movich4/LIPO-INFERNO/adhesivos/pdf/pegatina dreta.pdf

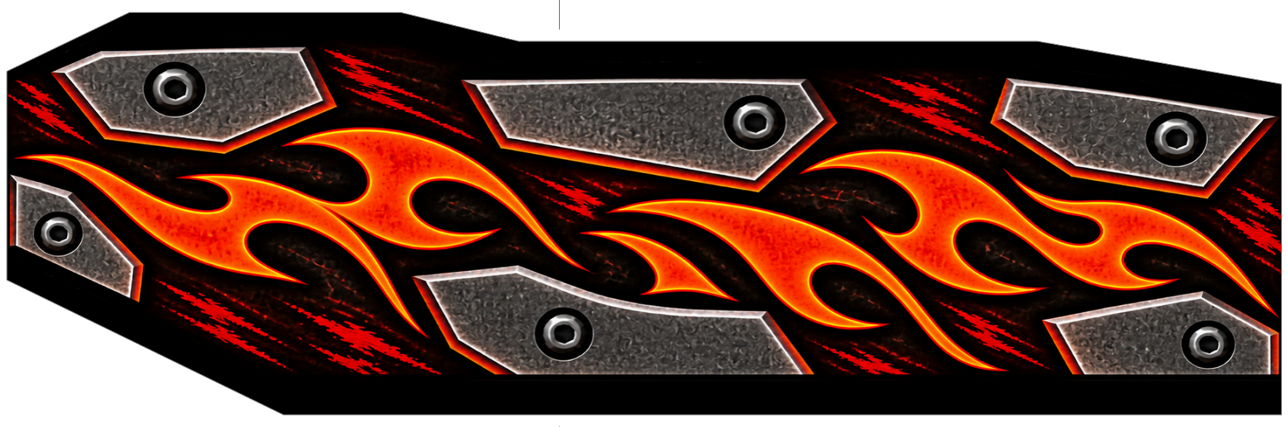
[picture p11: figure]

Plec 135 graus - no tallar

## LATERAL DRET - PECA UNICA

Cara 1: 47 mm | Cara 2: 61,4305 mm | Total: 108,4305 mm
Altura de la unio: 31,8 mm | Extrem dret: 28,1556 mm
Imprimir al 100% / mida real. No ajustar a la pagina ni fer mirall.
Retallar el contorn. Doblegar per les marques exteriors, sense tallar la unio.

Control: 50 mm
