movich4/LIPO-INFERNO/adhesivos/pdf/pegatina esquerra.pdf

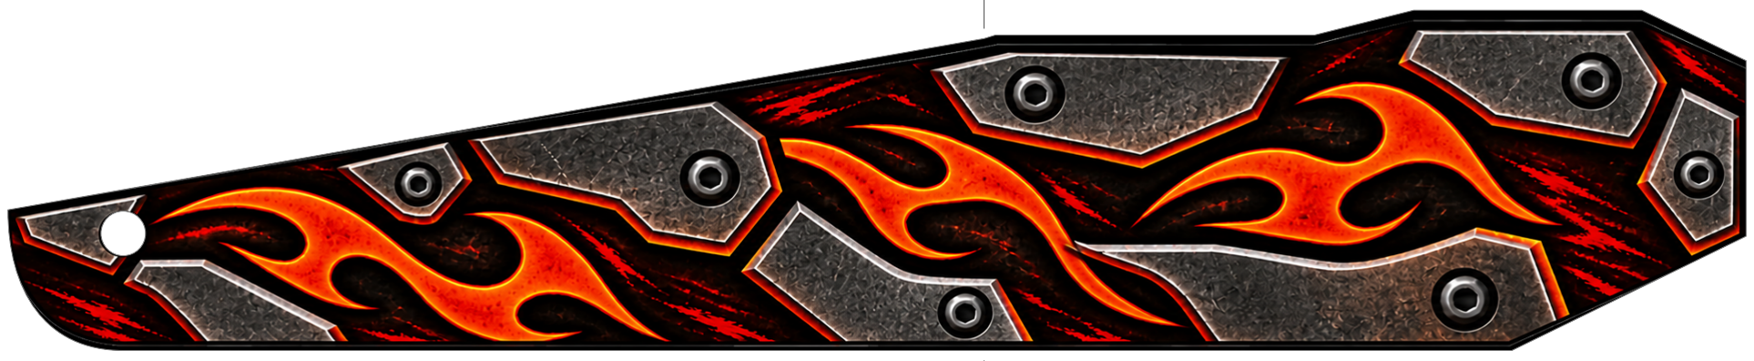
[picture p12: figure]

Plec 135 graus - no tallar

## LATERAL ESQUERRE - PECA UNICA

Cara 1: 98,6363 mm | Cara 2: 77 mm | Total: 175,6363 mm
Altura de la unio: 31,4915 mm | Forat: diametre 4,5 mm
Imprimir al 100% / mida real. No ajustar a la pagina.
Retallar nomes el contorn i el forat. Doblegar per les marques exteriors.

Control: 50 mm
