movich4/LIPO-INFERNO/adhesivos/pdf/Pegatina superior.pdf

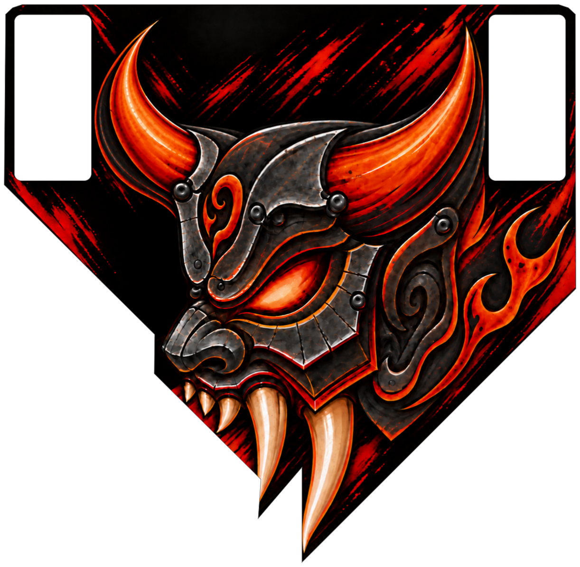
[picture p13: figure]

Imprimir al 100% / mida real. No ajustar a la pagina.
Amplada exterior: 165 mm. Retallar el contorn i els forats blancs.

Control: 50 mm
