movich4/LIPO-INFERNO/adhesivos/pdf/pegatina_inferior.pdf

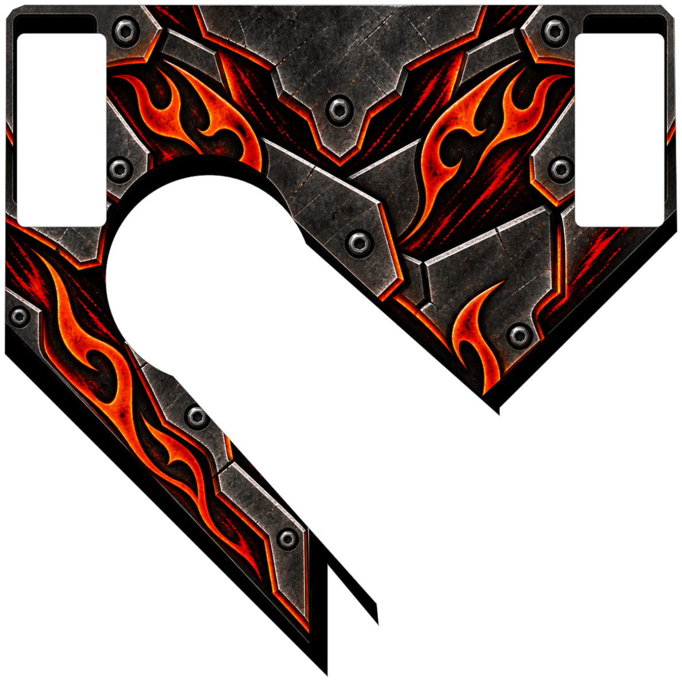
[picture p14: figure]

Sota del xassis - amplada 165 mm - vora superior +4 mm Forats i zona inferior conservats. Contorn ja en mirall. Imprimir al 100%. No ajustar a la pagina ni tornar a fer mirall.

Control: 50 mm
