movich4/LIPO-INFERNO/THIRD_PARTY.md

# Material y derechos de terceros

Las licencias del proyecto cubren las aportaciones propias de movich4. No conceden derechos que pertenezcan a otras personas o entidades.

## Imágenes de anuncios

Los siguientes archivos se presentan en el README como imágenes del anuncio de la motosierra:

- `media/imagenes/desarrollo/Aliexpress.png`
- `media/imagenes/desarrollo/pes_original.png`

Se excluyen de la dedicación CC0 del proyecto. No consta aquí una licencia de reutilización concedida por sus titulares. Su presencia en este repositorio no concede permiso para reutilizar esos anuncios.

## Otros elementos externos

Los derechos de terceros sobre marcas, logotipos, interfaces o contenido externo que pueda aparecer en capturas, fotografías, vídeos o gráficos permanecen con sus respectivos titulares. La licencia del material propio no concede por sí sola derechos sobre esos elementos ni implica su respaldo al proyecto.

Las bibliotecas y herramientas externas utilizadas para compilar o desarrollar el robot mantienen sus respectivas licencias. La licencia MIT del código propio no sustituye las condiciones de esas dependencias.
