movich4/LIPO-INFERNO/media/imagenes/desarrollo/60ca14e7-3f66-41a6-87e7-86d295f8432b.jpg

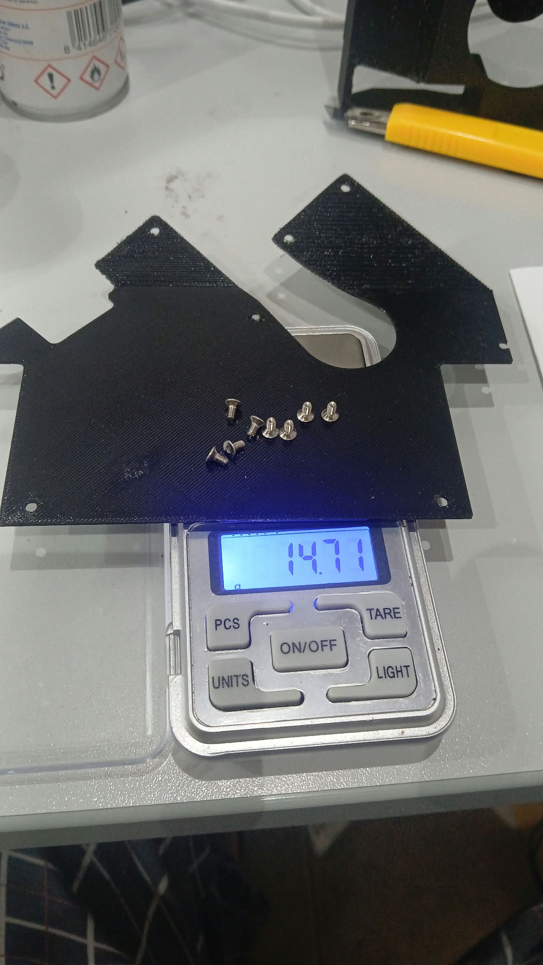
media/imagenes/desarrollo/60ca14e7-3f66-41a6-87e7-86d295f8432b.jpg
