movich4/LIPO-INFERNO/media/imagenes/desarrollo/92ebfd58-8bb9-44ca-aabc-aaffa1bcd1ce.jpg

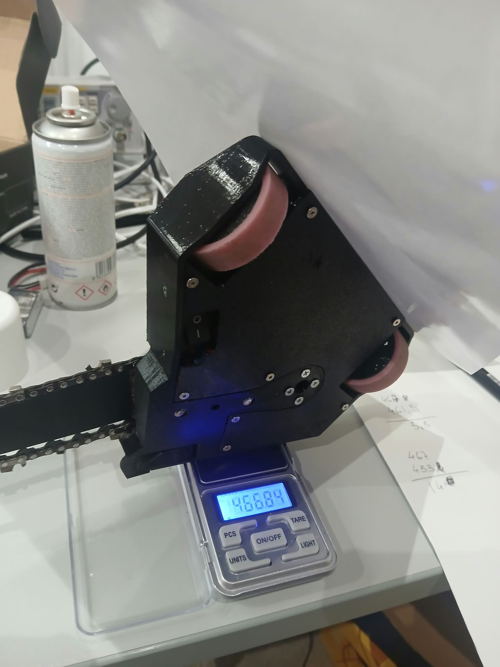
media/imagenes/desarrollo/92ebfd58-8bb9-44ca-aabc-aaffa1bcd1ce.jpg
