movich4/LIPO-INFERNO/media/imagenes/desarrollo/536af13c-256c-49a1-b3da-b9dbb056d0e5.jpg

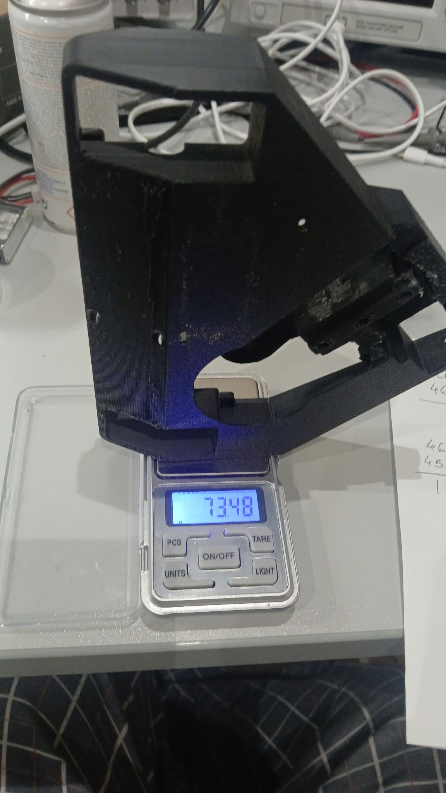
media/imagenes/desarrollo/536af13c-256c-49a1-b3da-b9dbb056d0e5.jpg
