movich4/LIPO-INFERNO/media/imagenes/desarrollo/af1d88e6-dc71-4df8-9051-c0cca1b3e629.jpg

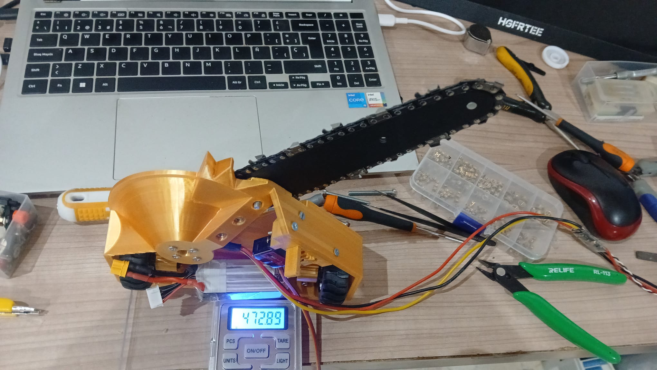
media/imagenes/desarrollo/af1d88e6-dc71-4df8-9051-c0cca1b3e629.jpg
