movich4/LIPO-INFERNO/media/imagenes/desarrollo/brushless_1.png

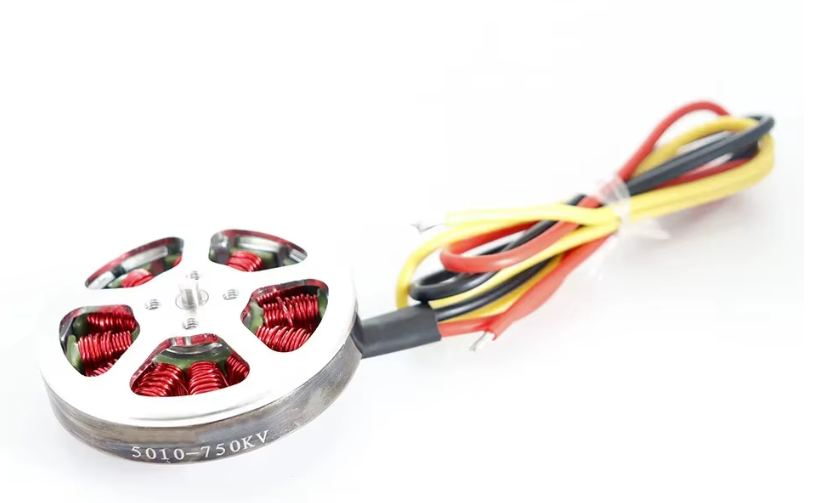
media/imagenes/desarrollo/brushless_1.png
