movich4/LIPO-INFERNO/media/imagenes/desarrollo/camiseta.png

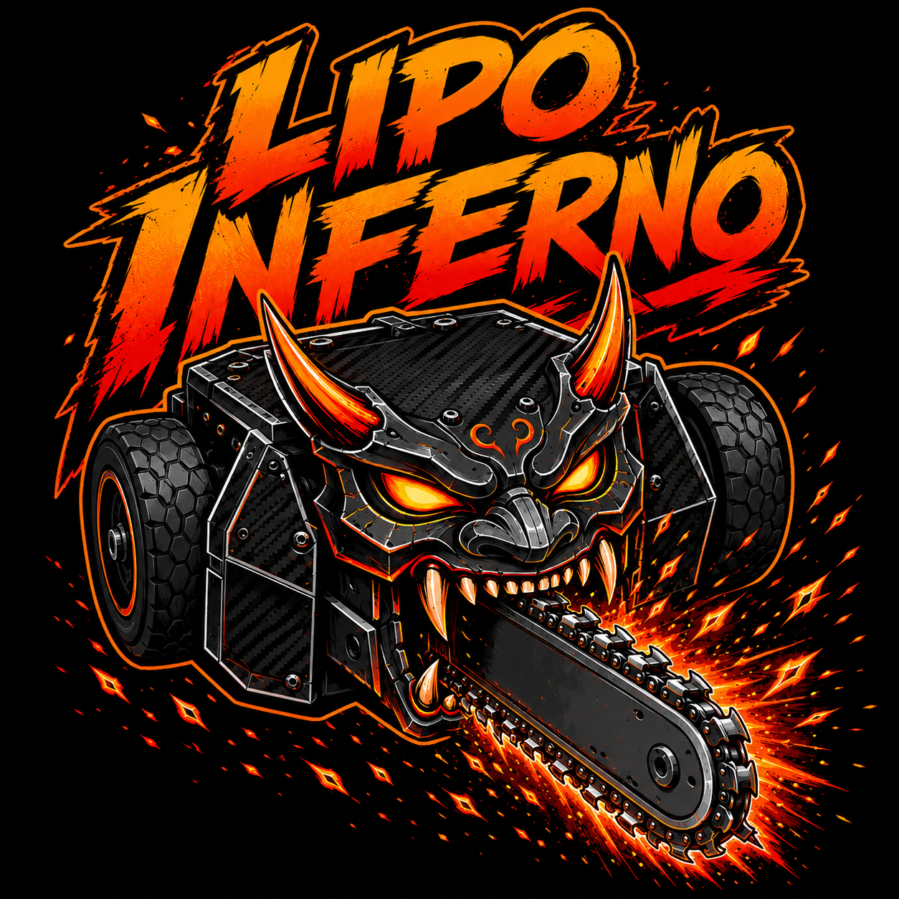
media/imagenes/desarrollo/camiseta.png
