movich4/LIPO-INFERNO/media/imagenes/desarrollo/Captura de pantalla 2026-10-26 194523.png

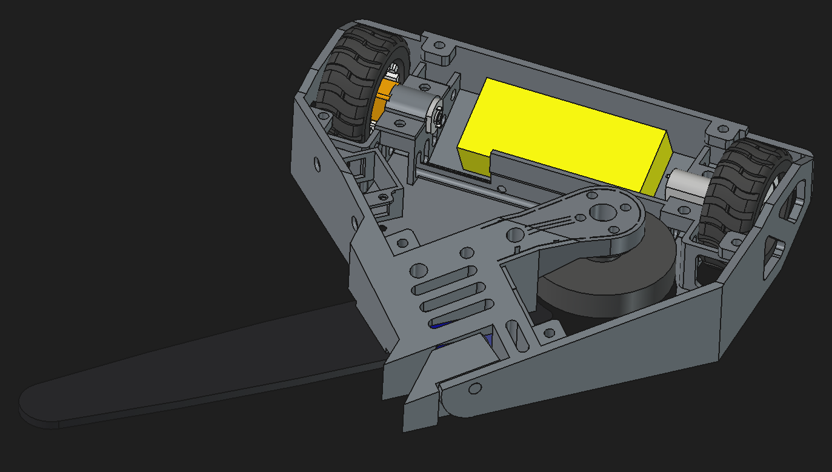
media/imagenes/desarrollo/Captura de pantalla 2026-10-26 194523.png
