movich4/LIPO-INFERNO/media/imagenes/desarrollo/concepte-lipo-inferno.png

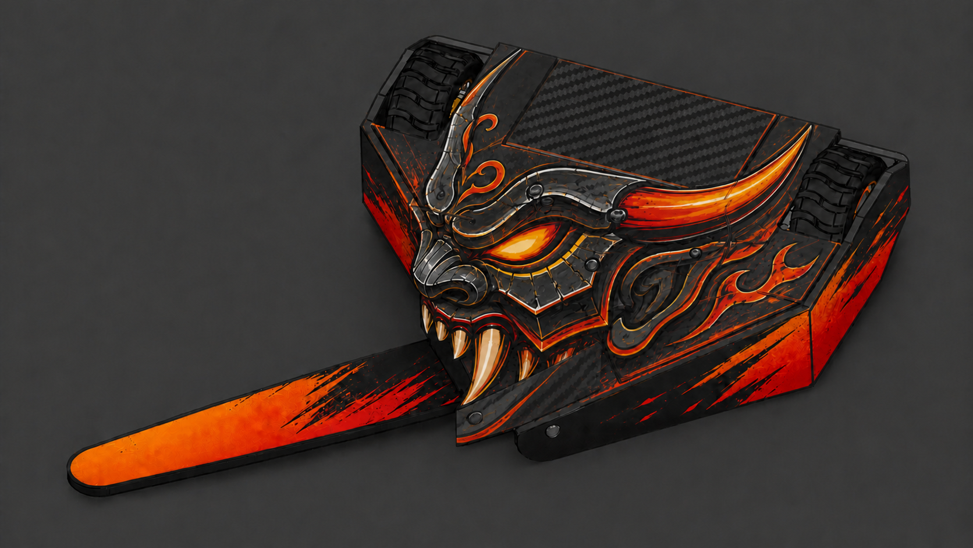
media/imagenes/desarrollo/concepte-lipo-inferno.png
