movich4/LIPO-INFERNO/media/imagenes/desarrollo/d8155282-41f2-4d60-a6fd-6150cf6f09d9.jpg

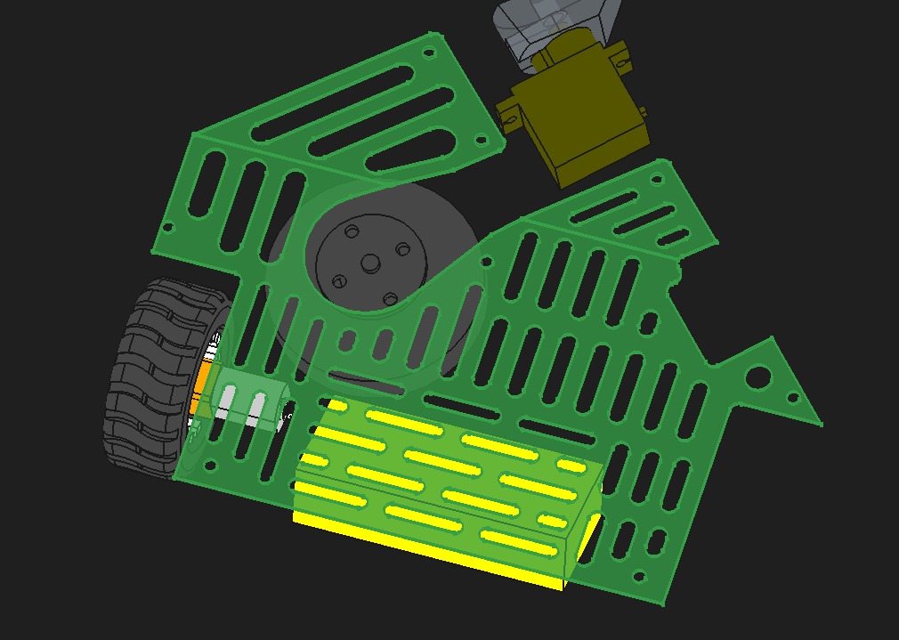
media/imagenes/desarrollo/d8155282-41f2-4d60-a6fd-6150cf6f09d9.jpg
