movich4/LIPO-INFERNO/media/imagenes/desarrollo/ef5335f4-c31e-446f-8f8a-f5f91df906e8.jpg

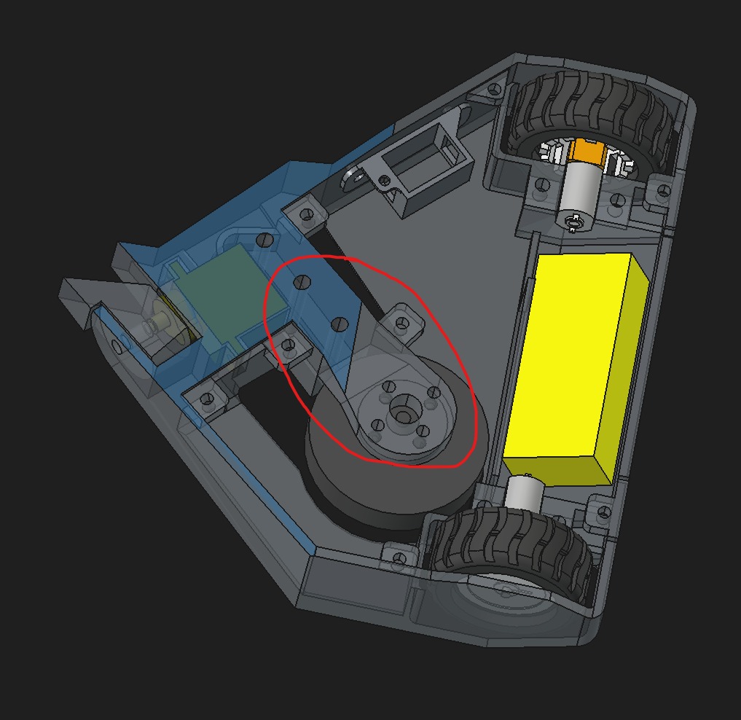
media/imagenes/desarrollo/ef5335f4-c31e-446f-8f8a-f5f91df906e8.jpg
