movich4/LIPO-INFERNO/media/imagenes/desarrollo/muntatge-interior.jpg

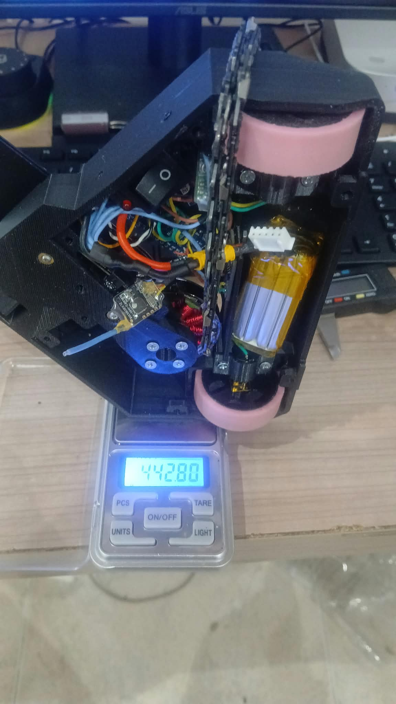
media/imagenes/desarrollo/muntatge-interior.jpg
