movich4/LIPO-INFERNO/media/imagenes/desarrollo/sumaker-team.png

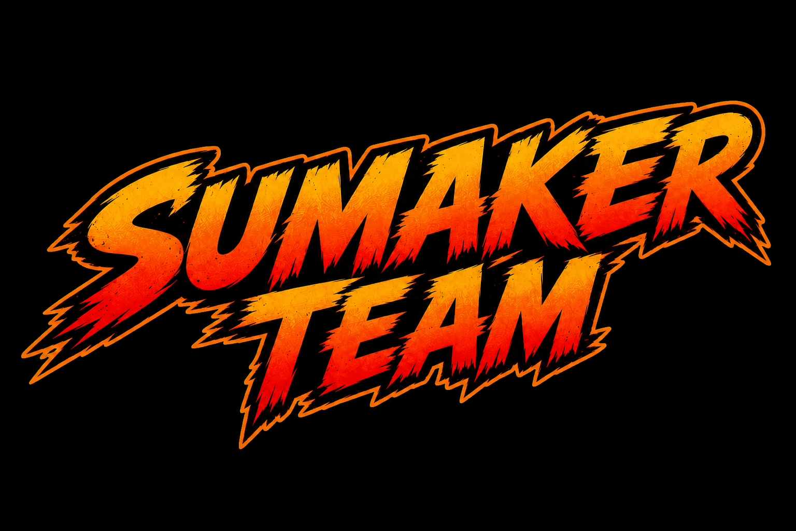
media/imagenes/desarrollo/sumaker-team.png
