movich4/LIPO-INFERNO/media/imagenes/robot/alternativas/20261031_154808-sin-fondo.png

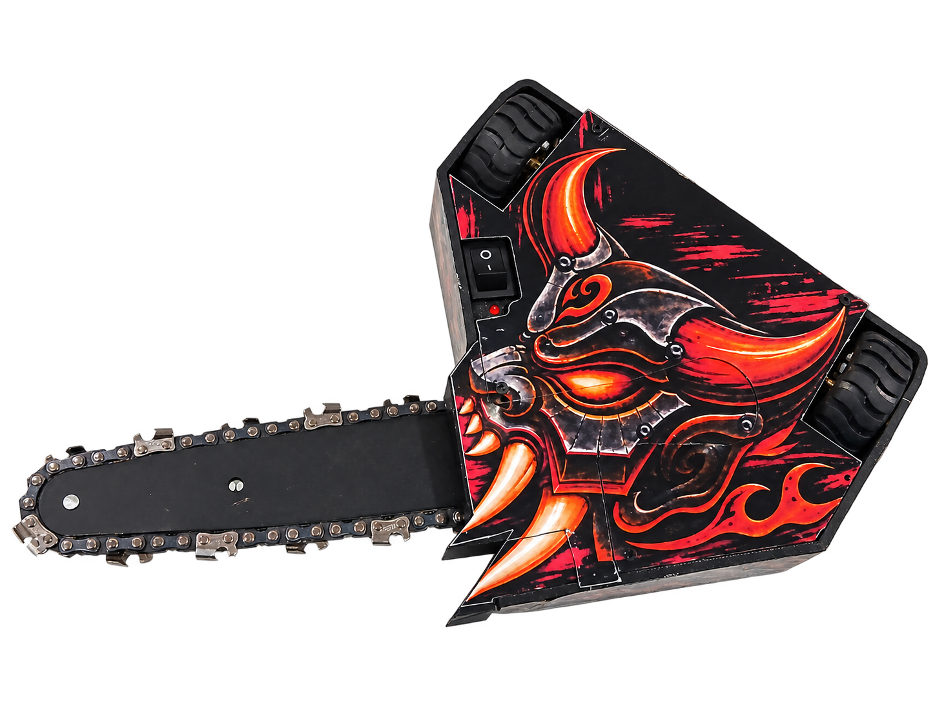
media/imagenes/robot/alternativas/20261031_154808-sin-fondo.png
