movich4/LIPO-INFERNO/media/imagenes/robot/originales/20261031_154808.jpg

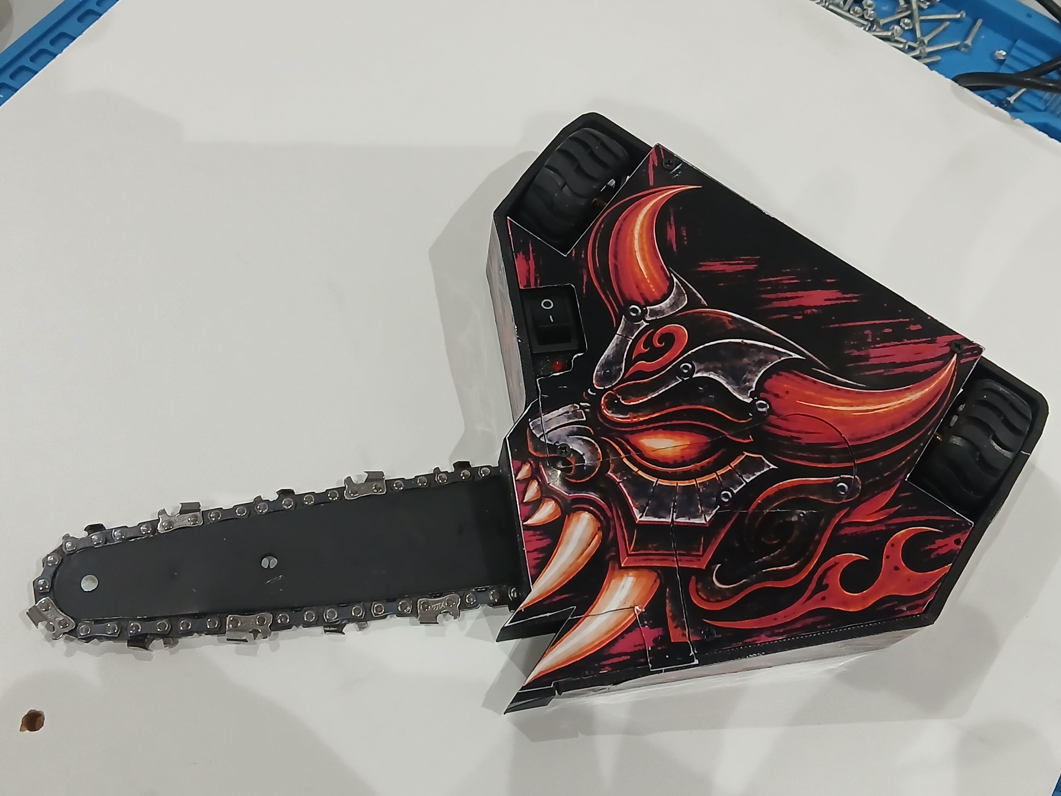
media/imagenes/robot/originales/20261031_154808.jpg
