movich4/LIPO-INFERNO/media/imagenes/robot/originales/20261031_154931.jpg

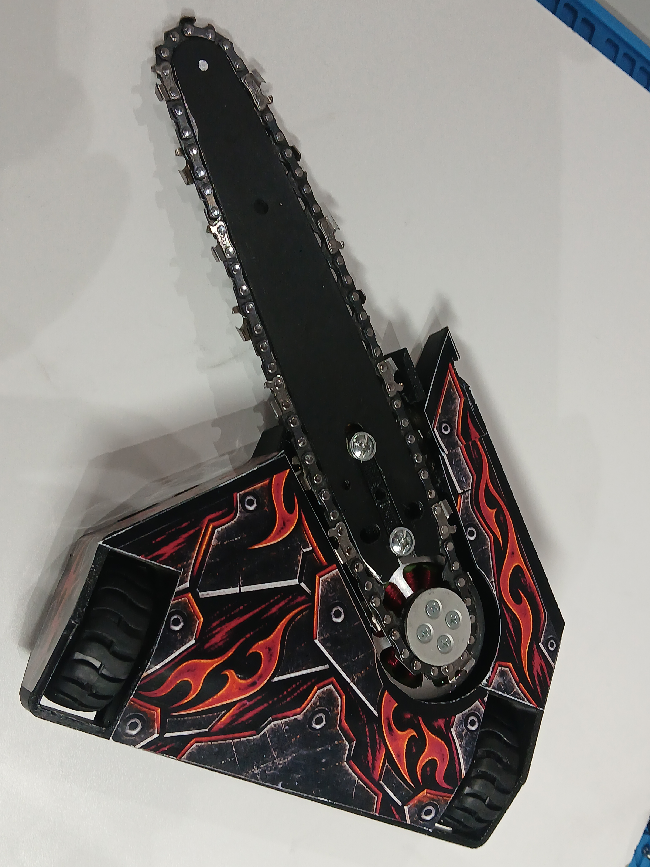
media/imagenes/robot/originales/20261031_154931.jpg
