movich4/LIPO-INFERNO/media/imagenes/robot/originales/20261031_155024.jpg

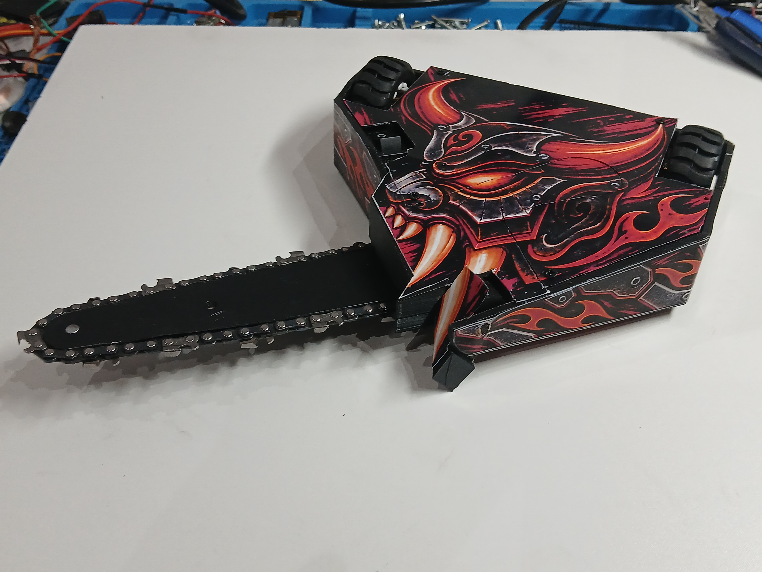
media/imagenes/robot/originales/20261031_155024.jpg
