movich4/LIPO-INFERNO/cad/freecad/cub_test.FCStd

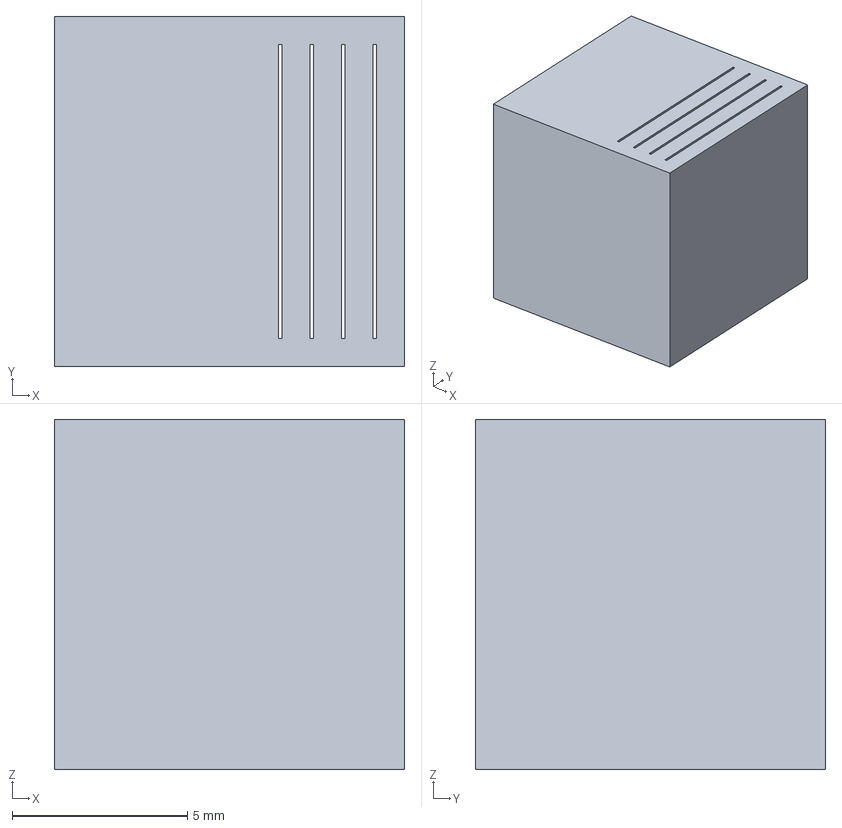
[picture p43: CAD file, 2026-10-31]
cad/freecad/cub_test.FCStd
10.0 x 10.0 x 10.0 mm
