movich4/LIPO-INFERNO/cad/step/tapa pinyo cadena.step

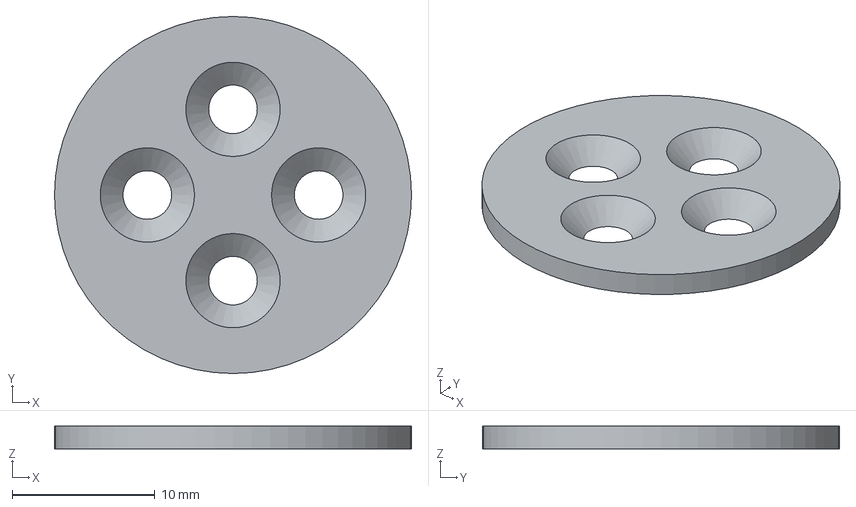
[picture p44: CAD file, 2026-10-31]
cad/step/tapa pinyo cadena.step
25.0 x 25.0 x 1.60 mm
