movich4/LIPO-INFERNO/cad/freecad/grup_servo.FCStd

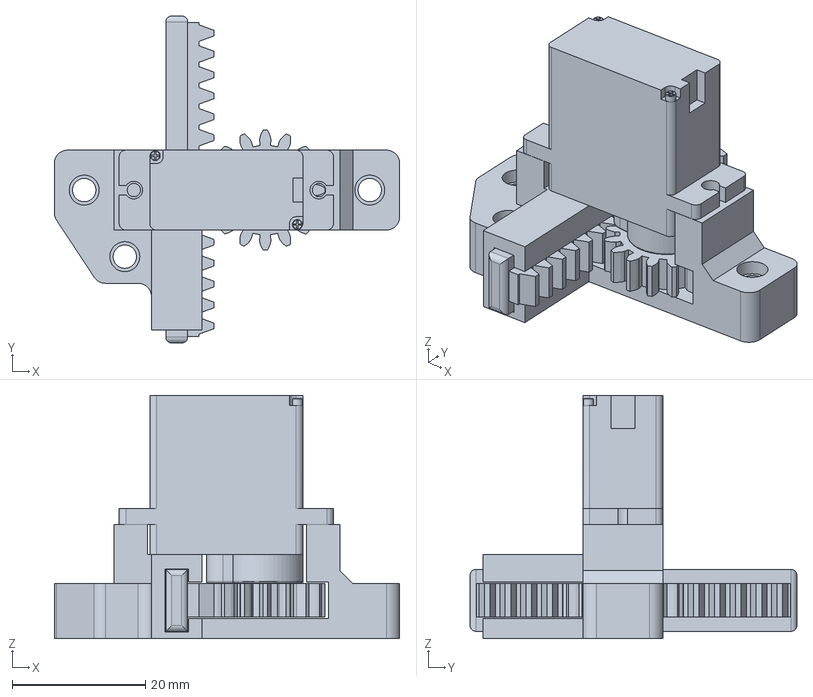
[picture p46: CAD file, 2026-10-31]
cad/freecad/grup_servo.FCStd
51.9 x 49.1 x 36.5 mm
