movich4/LIPO-INFERNO/cad/step/corona.step

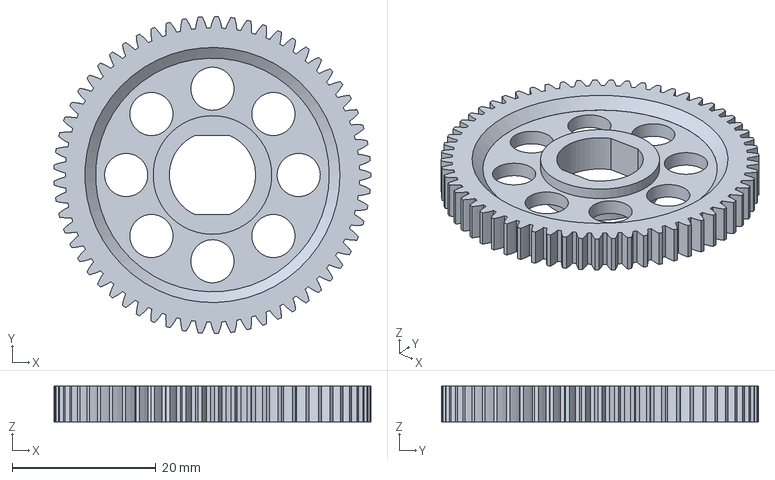
[picture p47: CAD file, 2026-10-31]
cad/step/corona.step
44.1 x 44.1 x 5.00 mm
