movich4/LIPO-INFERNO/impresion_3d/stl/eje_pota_servo.stl

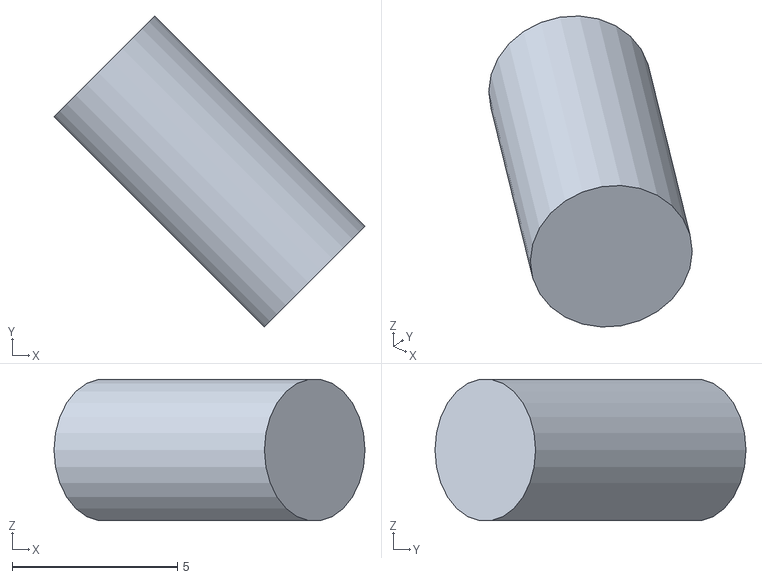
[picture p48: CAD file, 2026-10-31]
impresion_3d/stl/eje_pota_servo.stl
9.40 x 9.40 x 4.27
