movich4/LIPO-INFERNO/cad/freecad/Soport_interruptor.FCStd

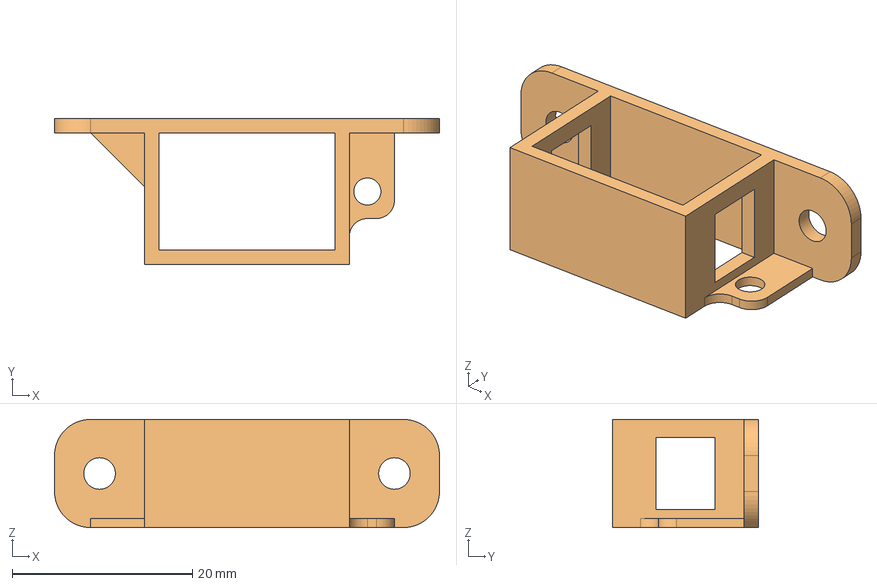
[picture p49: CAD file, 2026-10-31]
cad/freecad/Soport_interruptor.FCStd
42.7 x 16.2 x 12.0 mm
Cos
Soport_interruptor_simple
