movich4/LIPO-INFERNO/impresion_3d/stl/roda-TAP_MOTLLE_2.stl

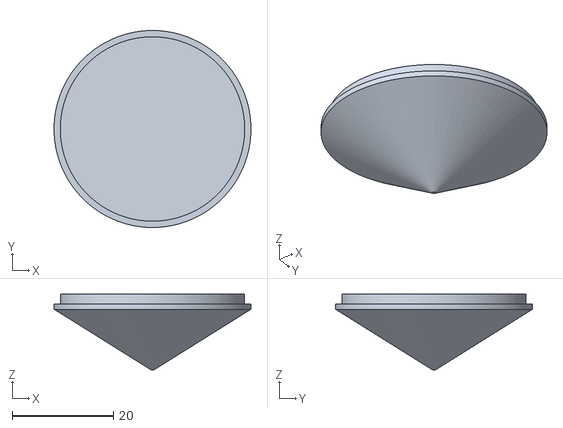
[picture p50: CAD file, 2026-10-31]
impresion_3d/stl/roda-TAP_MOTLLE_2.stl
39.0 x 39.0 x 15.0
