movich4/LIPO-INFERNO/cad/freecad/MF90_180graus.FCStd

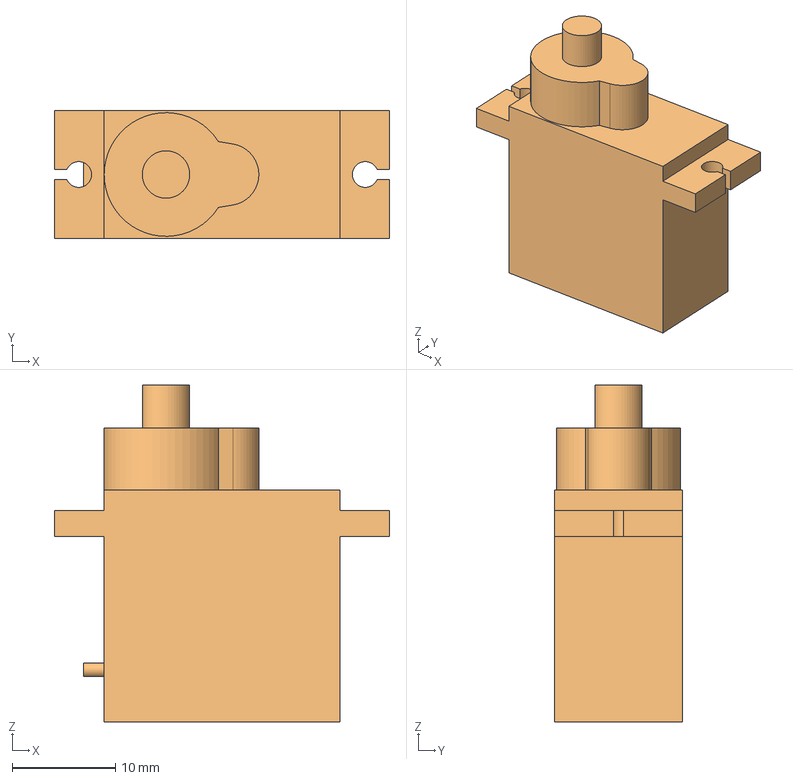
[picture p51: CAD file, 2026-10-31]
cad/freecad/MF90_180graus.FCStd
32.5 x 12.4 x 32.7 mm
MF90
MF90_copia_simple
