movich4/LIPO-INFERNO/impresion_3d/stl/motoserrator-Tapa.stl

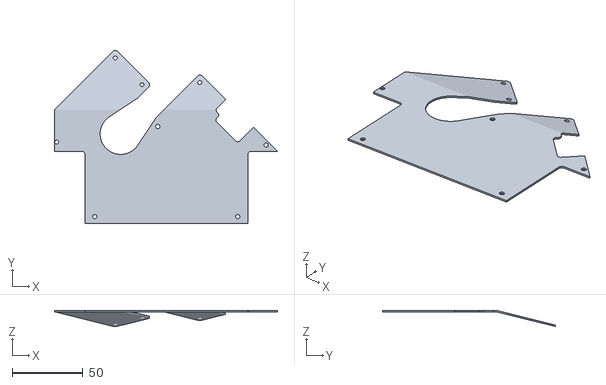
[picture p52: CAD file, 2026-10-31]
impresion_3d/stl/motoserrator-Tapa.stl
157.7 x 122.6 x 11.4
