movich4/LIPO-INFERNO/cad/freecad/soport_ESC.FCStd

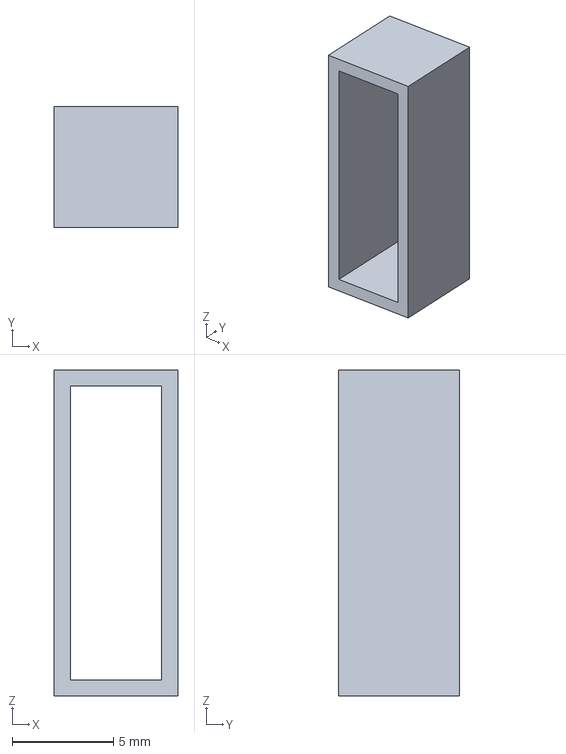
[picture p53: CAD file, 2026-10-31]
cad/freecad/soport_ESC.FCStd
6.10 x 6.00 x 16.1 mm
