movich4/LIPO-INFERNO/cad/freecad/motoserrator.FCStd

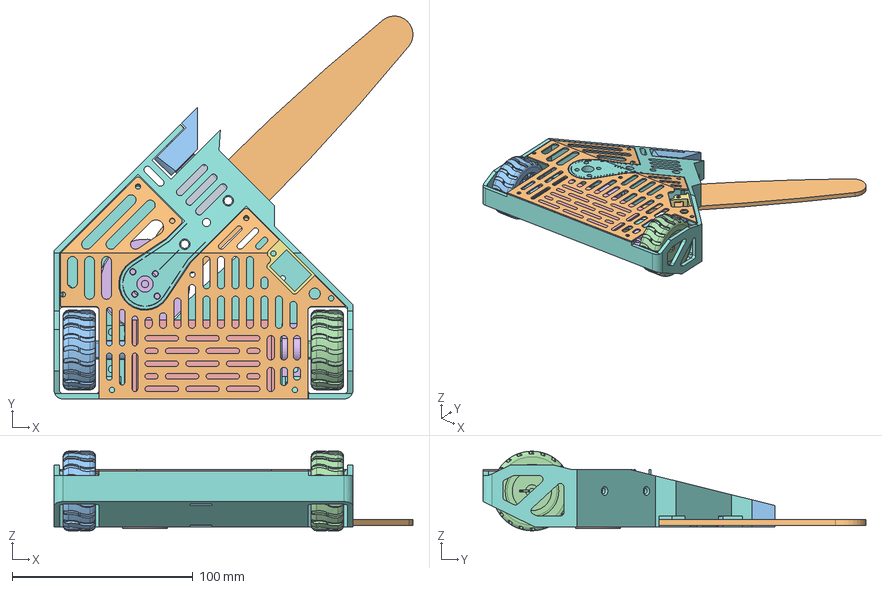
[picture p54: CAD file, 2026-10-31]
cad/freecad/motoserrator.FCStd
198.4 x 211.7 x 44.0 mm
Pinyo cadena
espasa
motor_rueda_simple_izq
motor_rueda_simple_der
tapa pinyo cadena
motor 5010
Bateria_4S
Xassis_2
SG90_dret_horitzontal003
Tapa
pota_servo
eje_pota_servo
tapa_bateria
BRIDA_MOTOR
Soport_interruptor_simple
