movich4/LIPO-INFERNO/impresion_3d/stl/motoserrator-Xassis_foradat.stl

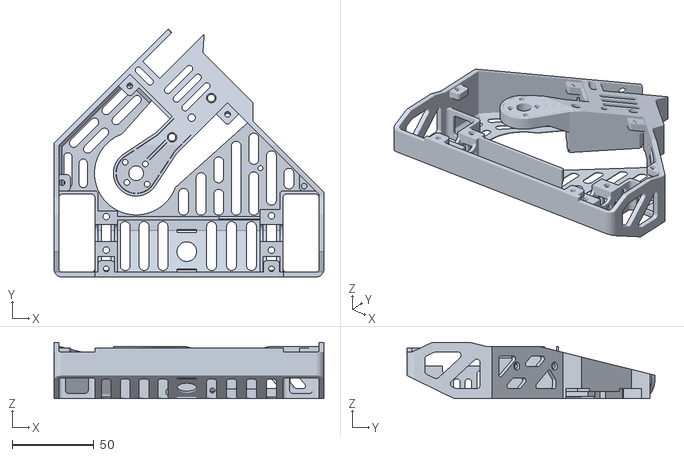
[picture p55: CAD file, 2026-10-31]
impresion_3d/stl/motoserrator-Xassis_foradat.stl
165.3 x 151.9 x 34.5
