movich4/LIPO-INFERNO/cad/freecad/roda.FCStd

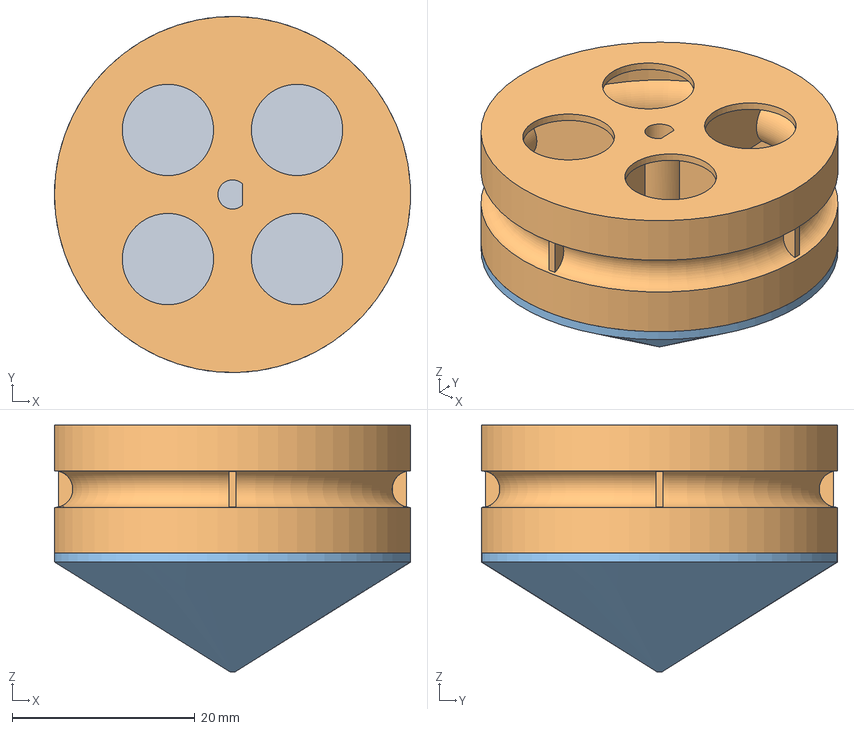
[picture p56: CAD file, 2026-10-31]
cad/freecad/roda.FCStd
39.0 x 39.0 x 27.0 mm
tap_motlle
Llanta001
TAP_MOTLLE_2
