movich4/LIPO-INFERNO/impresion_3d/stl/motoserrator-Tapa_aligerada.stl

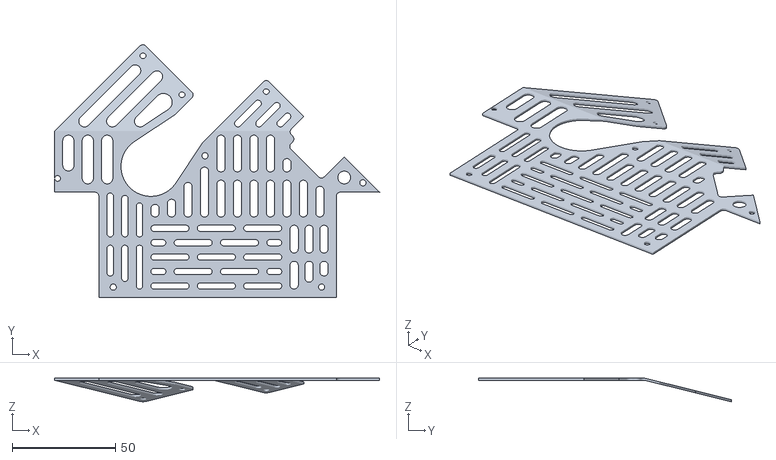
[picture p57: CAD file, 2026-10-31]
impresion_3d/stl/motoserrator-Tapa_aligerada.stl
157.7 x 122.6 x 11.4
