movich4/LIPO-INFERNO/impresion_3d/stl/base_servo.stl

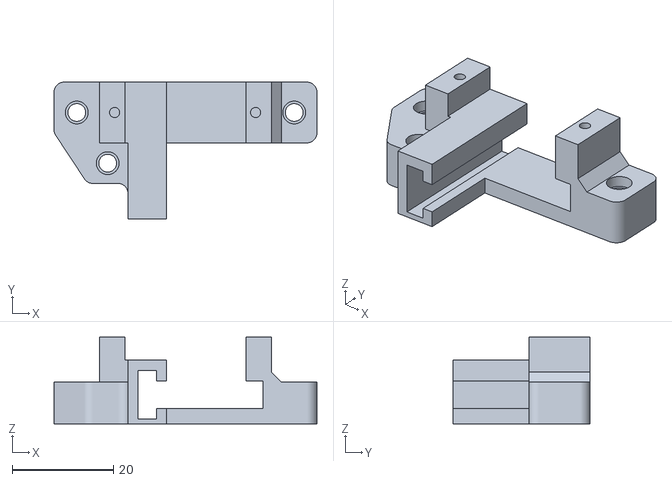
[picture p58: CAD file, 2026-10-31]
impresion_3d/stl/base_servo.stl
51.9 x 27.0 x 17.1
