movich4/LIPO-INFERNO/impresion_3d/stl/Soport motor_agarrador.stl

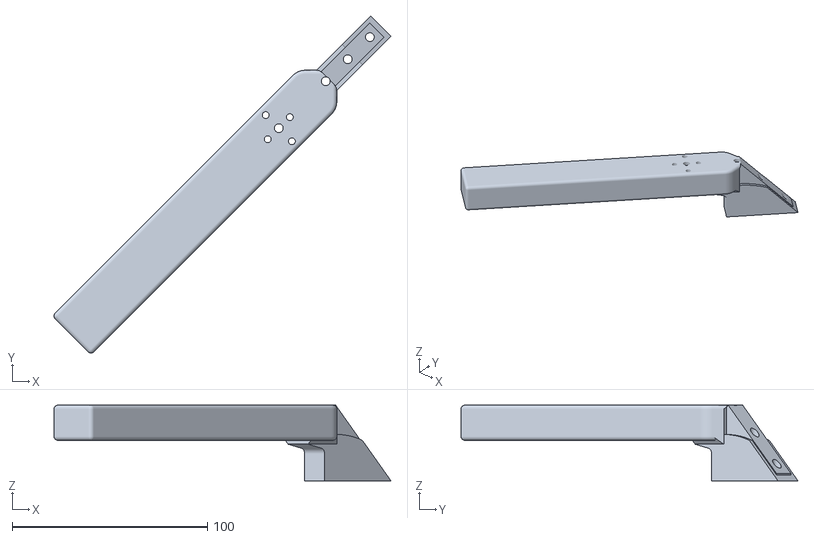
[picture p59: CAD file, 2026-10-31]
impresion_3d/stl/Soport motor_agarrador.stl
172.6 x 172.6 x 38.8
