movich4/LIPO-INFERNO/impresion_3d/stl/roda-Motlle_2.stl

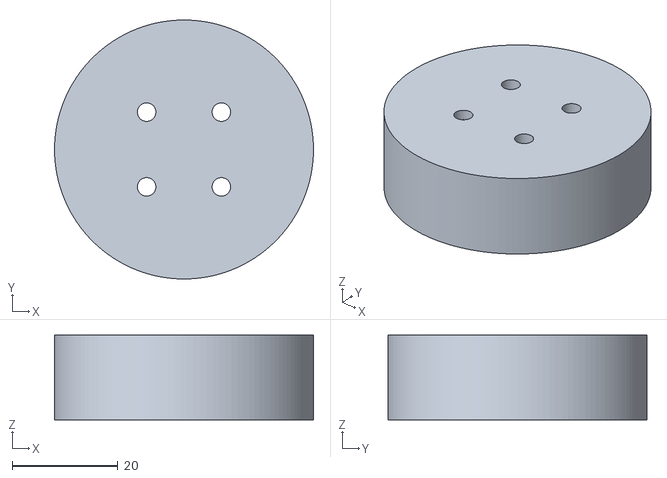
[picture p61: CAD file, 2026-10-31]
impresion_3d/stl/roda-Motlle_2.stl
49.0 x 49.0 x 16.0
