movich4/LIPO-INFERNO/impresion_3d/stl/pinyo_servo.stl

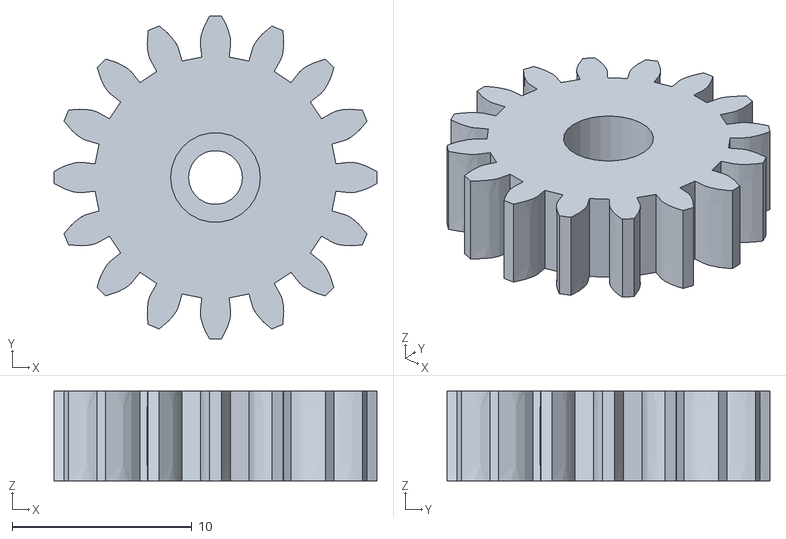
[picture p62: CAD file, 2026-10-31]
impresion_3d/stl/pinyo_servo.stl
18.0 x 18.0 x 5.00
