movich4/LIPO-INFERNO/impresion_3d/stl/roda-Llanta001.stl

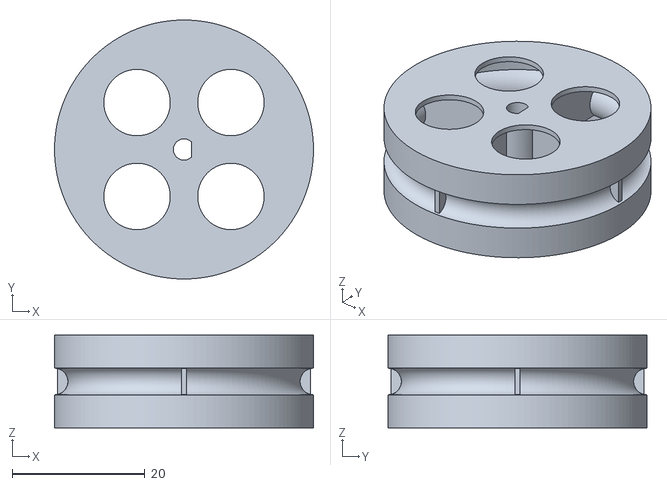
[picture p63: CAD file, 2026-10-31]
impresion_3d/stl/roda-Llanta001.stl
39.0 x 39.0 x 14.0
