movich4/LIPO-INFERNO/impresion_3d/stl/motoserrator-xassis.stl

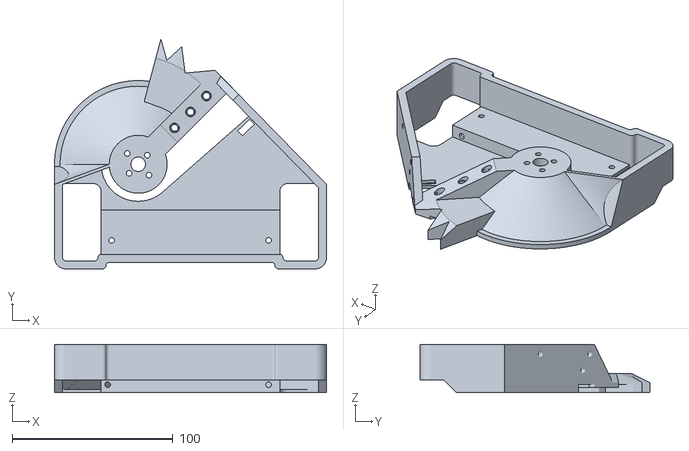
[picture p64: CAD file, 2026-10-31]
impresion_3d/stl/motoserrator-xassis.stl
169.0 x 142.7 x 30.0
