movich4/LIPO-INFERNO/impresion_3d/stl/roda-tap_motlle.stl

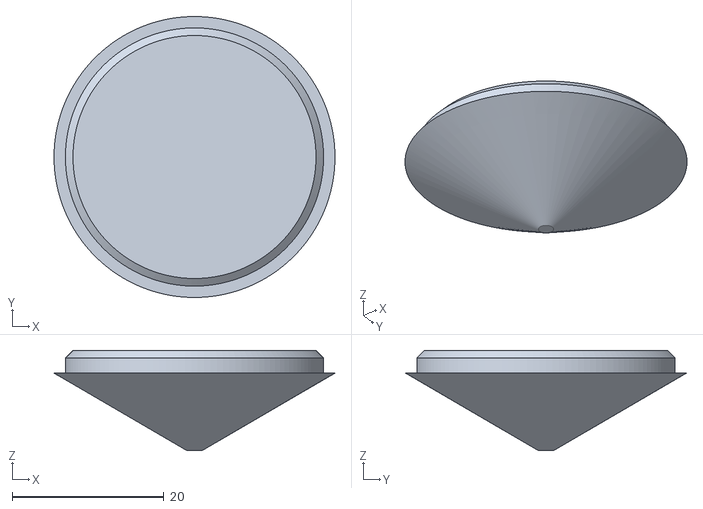
[picture p65: CAD file, 2026-10-31]
impresion_3d/stl/roda-tap_motlle.stl
37.0 x 37.0 x 13.2
