movich4/LIPO-INFERNO/impresion_3d/stl/pota_servo_180.stl

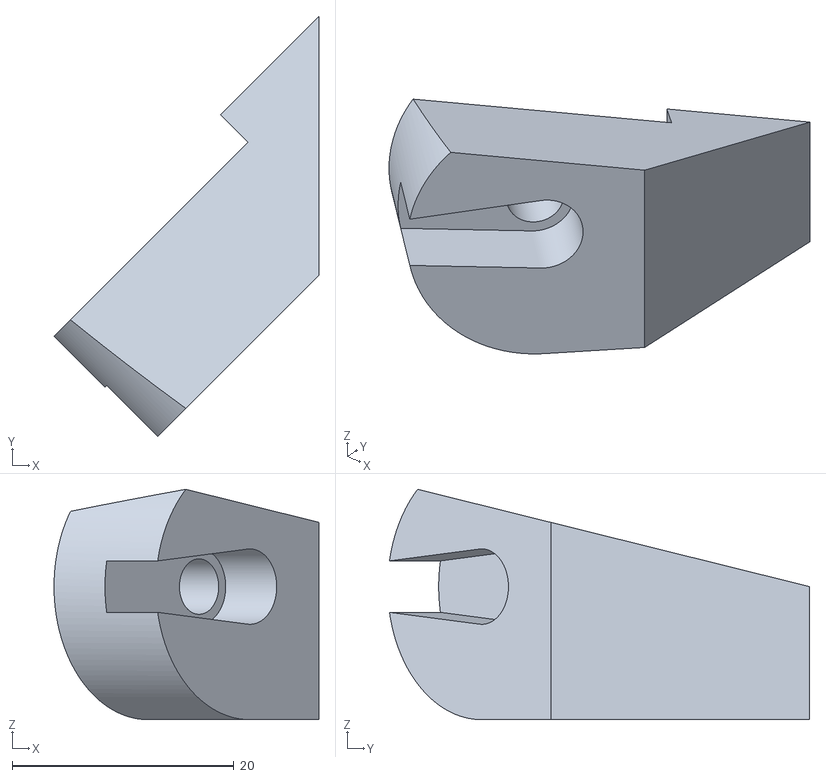
[picture p66: CAD file, 2026-10-31]
impresion_3d/stl/pota_servo_180.stl
23.9 x 37.9 x 20.8
