movich4/LIPO-INFERNO/impresion_3d/stl/roda-centrador.stl

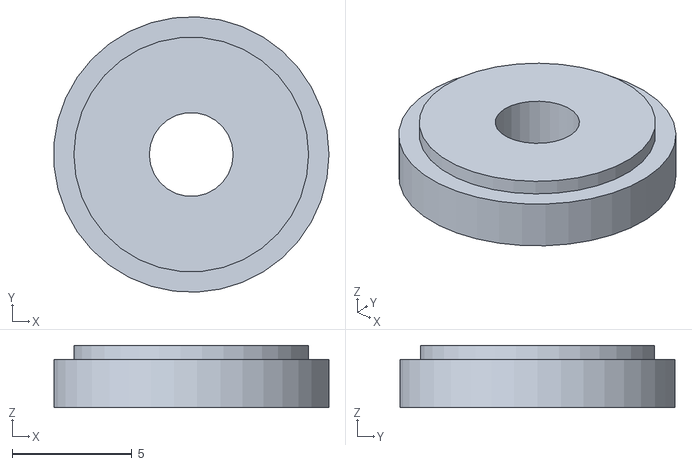
[picture p67: CAD file, 2026-10-31]
impresion_3d/stl/roda-centrador.stl
11.5 x 11.5 x 2.60
