movich4/LIPO-INFERNO/impresion_3d/stl/Pinyo cadena.stl

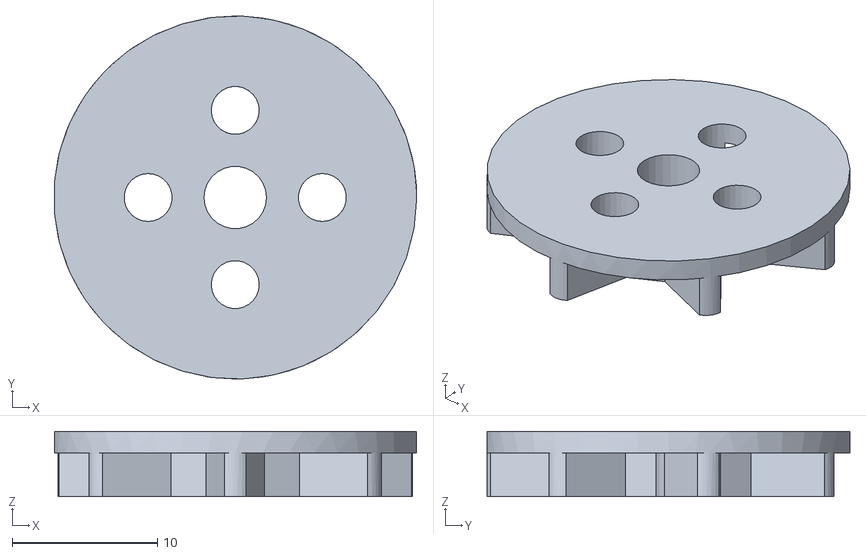
[picture p68: CAD file, 2026-10-31]
impresion_3d/stl/Pinyo cadena.stl
25.0 x 25.0 x 4.50
