movich4/LIPO-INFERNO/impresion_3d/stl/roda-Llanta.stl

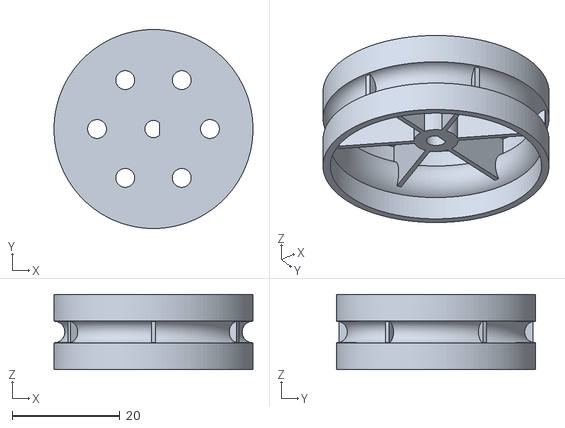
[picture p69: CAD file, 2026-10-31]
impresion_3d/stl/roda-Llanta.stl
37.0 x 37.0 x 14.0
