movich4/LIPO-INFERNO/impresion_3d/stl/motoserrator-BRIDA_MOTOR.stl

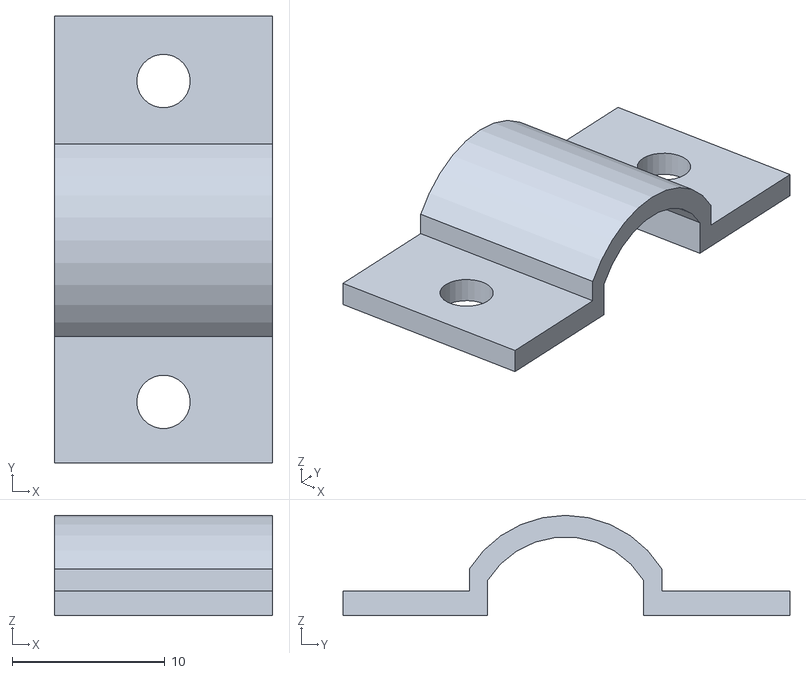
[picture p70: CAD file, 2026-10-31]
impresion_3d/stl/motoserrator-BRIDA_MOTOR.stl
14.3 x 29.3 x 6.57
