movich4/LIPO-INFERNO/impresion_3d/stl/Soport_interruptor.stl

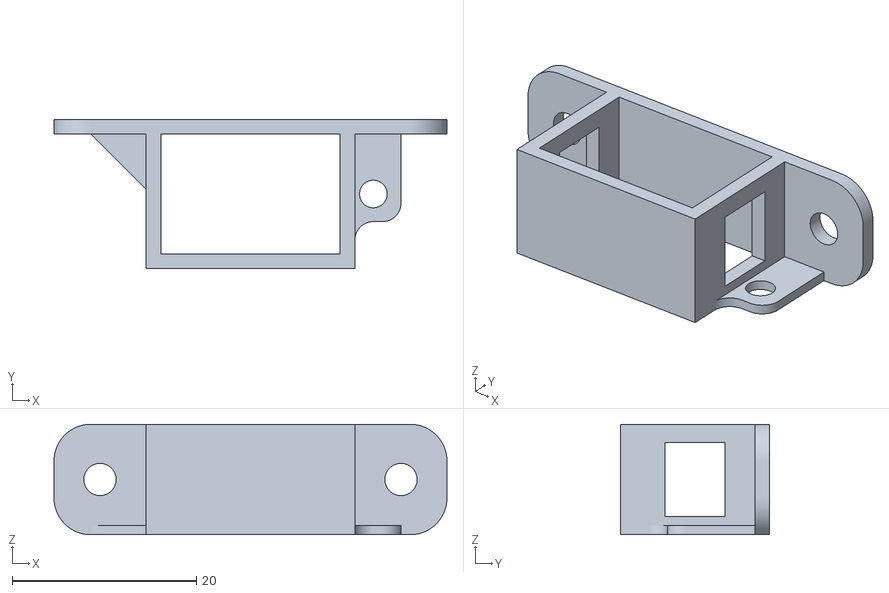
[picture p71: CAD file, 2026-10-31]
impresion_3d/stl/Soport_interruptor.stl
42.7 x 16.2 x 12.0
