movich4/LIPO-INFERNO/impresion_3d/stl/cremallera_servo.stl

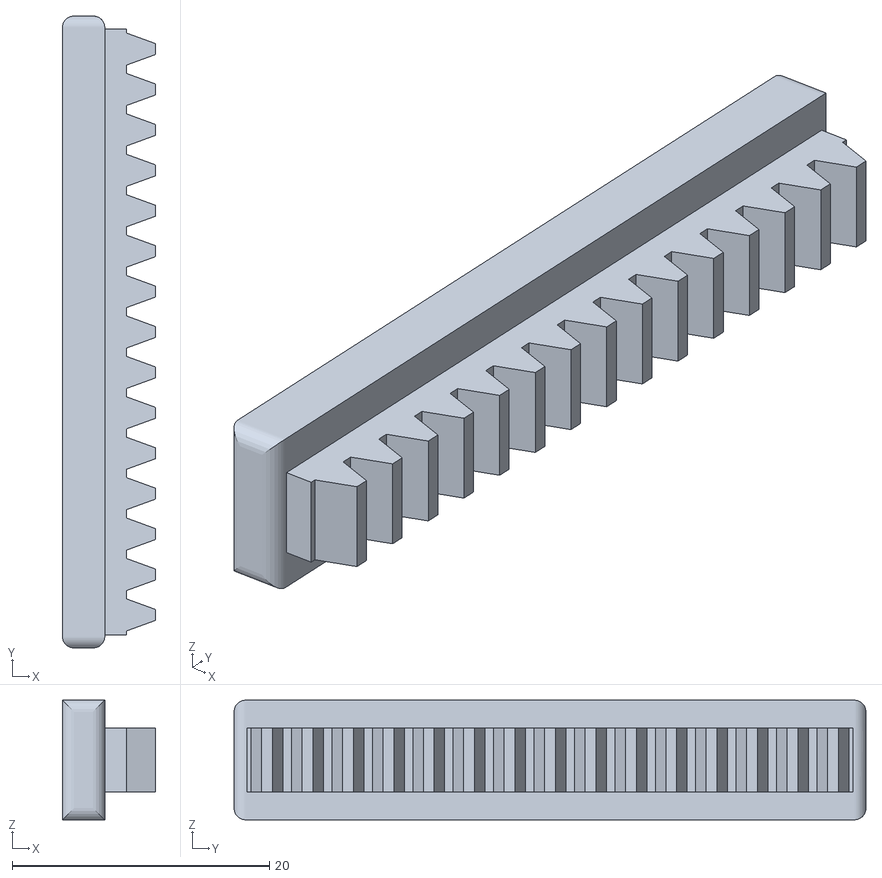
[picture p72: CAD file, 2026-10-31]
impresion_3d/stl/cremallera_servo.stl
7.25 x 49.1 x 9.30
