movich4/LIPO-INFERNO/impresion_3d/stl/soport_motor_dret.stl

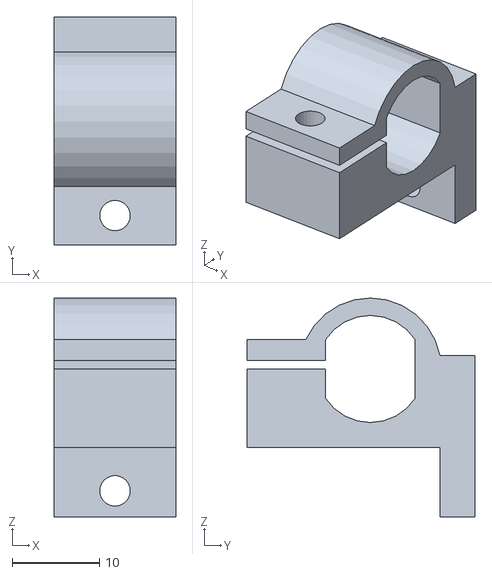
[picture p73: CAD file, 2026-10-31]
impresion_3d/stl/soport_motor_dret.stl
14.0 x 26.2 x 25.1
