movich4/LIPO-INFERNO/(list of files, cad)

Other CAD files:
impresion_3d/stl/corona.stl
impresion_3d/stl/soport_ESC.stl
impresion_3d/stl/roda-motlle.stl
