movich4/LIPO-INFERNO/(commit log)

2026-10-31 Publicar LIPO INFERNO: documentación, diseños, código y pruebas
    [MF90_180graus.FCStd, Pinyo cadena.stl, Soport motor_agarrador.stl, Soport_interruptor.FCStd, Soport_interruptor.stl, base_servo.stl, corona.step, corona.stl]
2026-10-31 Añadir licencias permisivas para código, hardware y documentación
